Avraamidou-Research-Group-CESE/modular-microcontroller-process-control-labs/Equipment.xlsx

Item Name | Item Number | Quantity | Price | Link
Adafruit NAU7802 24-Bit ADC - STEMMA QT / Qwiic | #4538 | 1 | $5.95 | https://www.adafruit.com/product/4538
Tubing for Submersible Pumps - PVC 6mm ID - 1 Meter Long | #4545 | 1 | $1.50 | https://www.adafruit.com/product/4545
Submersible 3V DC Water Pump - 1 Meter Vertical Type | #4547 | 2 | $2.95 | https://www.adafruit.com/product/4547
Breadboarding wire bundle | #153 | 1 | $4.95 | https://www.adafruit.com/product/153
Half Sized Premium Breadboard - 400 Tie Points | #64 | 1 | $4.95 | https://www.adafruit.com/product/4539
L9110H H-Bridge Motor Driver for DC Motors - 8 DIP - 2.5V-12V 800mA | #4489 | 2 | $1.50 | https://www.adafruit.com/product/4489
USB Cable - 6" Standard A-B | #900 | 1 | $2.95 | https://www.adafruit.com/product/900
Arduino Uno REV3 |  | 1 | $27.60 | https://www.amazon.com/Arduino-A000066-ARDUINO-UNO-R3/dp/B008GRTSV6
Geekstory 20kg Digital Load Cell Weight Sensor |  | 1 | $15.99 | https://www.amazon.com/Geekstory-Converter-Breakout-Electronic-Raspberry/dp/B0B6NRW8GG/
STEMMA QT / Qwiic JST SH 4-pin to Premium Male Headers Cable - 150mm Long | #4209 | 1 | $0.95 | https://www.digikey.com/en/products/detail/adafruit-industries-llc/4209/10230003
 |  | Total | $73.74
